basheeraltawil/Bachelor_of_Mechatronics_Engineering_Project/robocraft_ws/src/robocraft_interfaces/README.md

# robocraft_interfaces

| Message | Fields |
|---|---|
| `Obstacle` | `label` (colour class), `x`, `y`, `radius` [m], `confidence` |
| `ObstacleArray` | header + list of `Obstacle` (used for `/robocraft/obstacles` and `/robocraft/detections`) |
| `CellStatus` | mode, grasp state per arm, closure error, smallest interference margin, active task |
