basheeraltawil/Bachelor_of_Mechatronics_Engineering_Project/docs/images/sim_hero.png

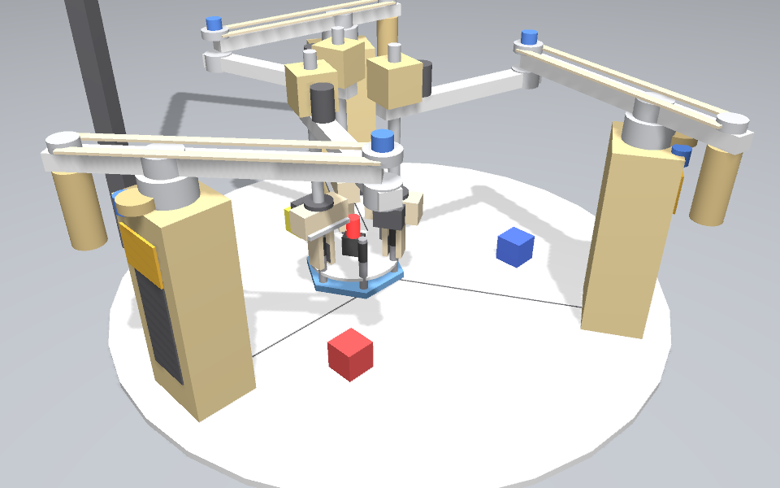
docs/images/sim_hero.png
