basheeraltawil/Bachelor_of_Mechatronics_Engineering_Project/docs/images/sim_phases.png

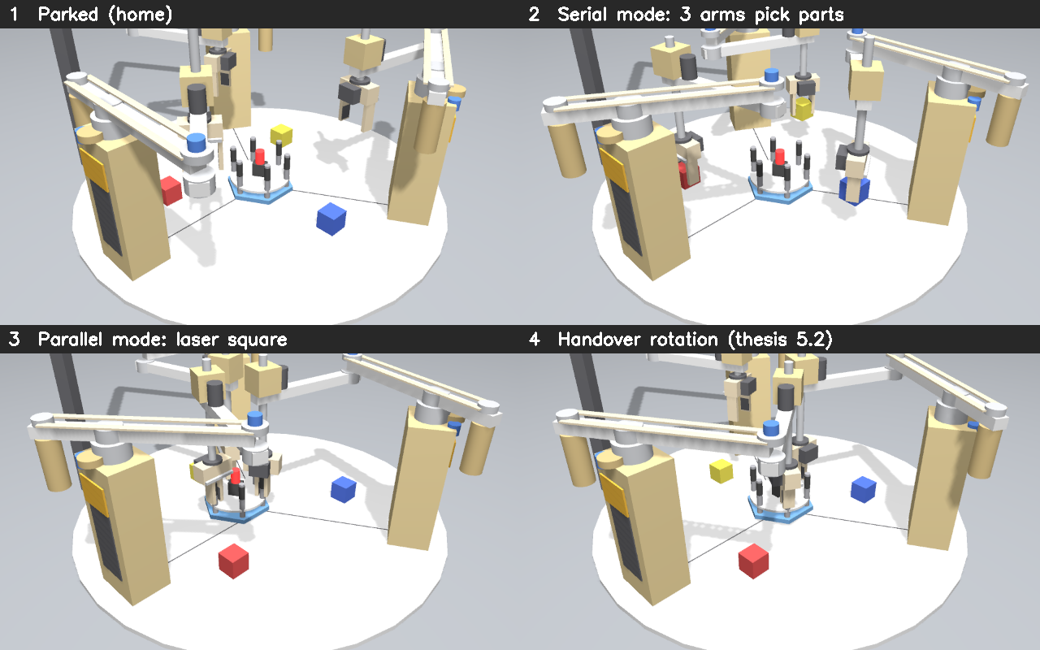
docs/images/sim_phases.png
