basheeraltawil/Bachelor_of_Mechatronics_Engineering_Project/(commit log)

2026-09-23 Add drawing square, pure rotation, and trajectory generation tasks
    - Implemented `drawing_square.py` for executing a square drawing task using two manipulators.
    - Created `pure_rotation.py` to handle rotation tasks with three manipulators, including servo control and inverse kinematics.
    - Developed `trajectory_generation.py` for calculating and generating trajectories for the manipulators based on given points and angles.
    - All scripts include necessary imports, setup for GPIO and I2C communication, and detailed comments for clarity.
2026-09-24 Add ROS 2 Humble workspace: industrial 4-axis SCARA cell with Gazebo scenarios
    Rebuild of the 2019 graduation project as a ROS 2 / Gazebo Fortress / ros2_control
    workspace (robocraft_ws):
    - robocraft_description: xacro model of the 3-arm cell from a single cell.yaml
    (thesis geometry; J3 quill + J4 wrist as industrial extension), hex platform
    with passive leg bearings, worlds with overhead camera and green obstacle
    - robocraft_kinematics: FK/IK/Jacobian, parallel platform IK/FK, corrected thesis
    via-point cubic, PTP/LIN profiles, inter-arm interference checks, workspace
    analysis, CRC-8 I2C protocol codec
    - robocraft_control: backend-agnostic CellCommander (serial/parallel modes),
    R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
    [common.xacro, controllers.yaml, controllers_gazebo.yaml, model.sdf, robocraft.ros2_control.xacro, robocraft_cell.sdf, robocraft_cell.urdf.xacro, robocraft_cell_obstacle.sdf]
2026-09-25 Reorganise the 2019 material into thesis_2019/
    thesis/, code_appendix/, figures/ and legacy_code/ with an index README
    that maps every thesis chapter to its modern counterpart.
2026-09-25 Add engineering analysis scripts with explained formulas
    Eight standalone scripts (workspace, kinematics, dynamics and motor sizing,
    link deflection, trajectory planning, sensor calibration, motor control
    tuning, parallel workspace) that read the same cell.yaml as the robot model,
    print their results and save figures to docs/images/analysis.
2026-09-25 Add vision sorting and laser cutting scenarios, improve readability
    - vision_detector replaces obstacle_detector: colour classes measured on the
    rendered scene, size-safe radius, /robocraft/detections for all objects
    - new scenarios: vision_sorting (inspection + reject bin) and
    laser_cutting_profile (hole first, then outline); scenario table with the
    real-world task of each scenario
    - commander, backend and scenario library documented for newcomers
    - firmware: model-based gains + velocity feed-forward (compiles for Uno)
    - sorting bins in the worlds, README per package, 39 tests
    [robocraft_cell.sdf, robocraft_cell_obstacle.sdf]
2026-09-25 Add documentation, CI, license and citation
    - concise landing README with demo GIFs, highlights and quick start
    - docs/: design, kinematics and control, simulation and scenarios,
    hardware, developer guide
    - GitHub Actions: build + tests in ros:humble, analysis scripts, firmware
    - MIT license and CITATION.cff
2026-09-25 CI: checkout@v5 (Node 24) and pin the firmware runner to Ubuntu 24.04
2026-09-25 Fix duplicate inverse kinematics equation
    Removed duplicate equation for inverse kinematics.
2026-09-25 Improve kinematics documentation with detailed equations
    Enhanced mathematical expressions and added definitions for rotation matrix and pose calculations in the kinematics documentation.
2026-09-25 Remove duplicate forward kinematics equation
    Removed duplicate equation for forward kinematics in the documentation.
