basheeraltawil/Bachelor_of_Mechatronics_Engineering_Project/(notices)

Notices in the files:
README.md:
License: MIT
